ksmonkey123/moba3/docs/images/ref/left details.JPEG

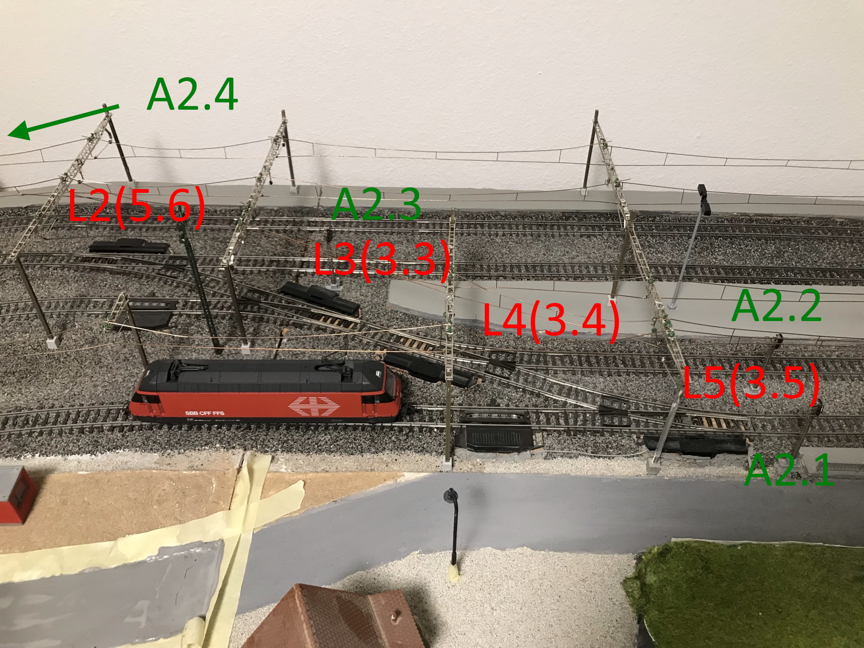
docs/images/ref/left details.JPEG
