ksmonkey123/moba3/docs/images/ref/left overview.JPEG

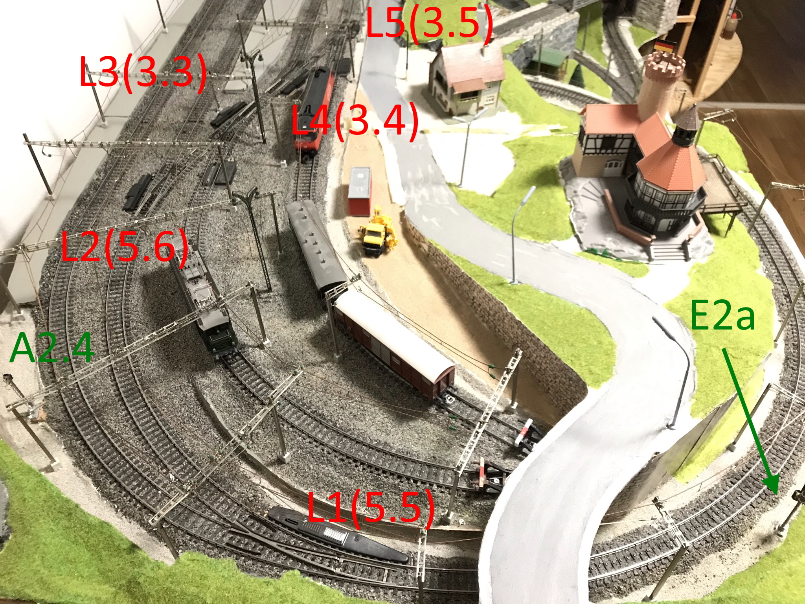
docs/images/ref/left overview.JPEG
