ksmonkey123/moba3/docs/images/ref/right front.JPEG

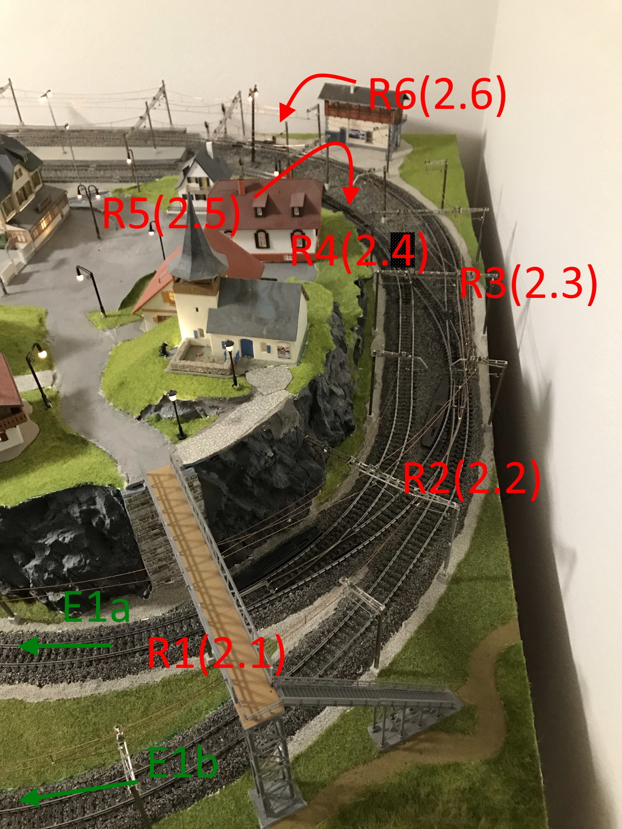
docs/images/ref/right front.JPEG
