ksmonkey123/moba3/docs/images/ref/right rear.JPEG

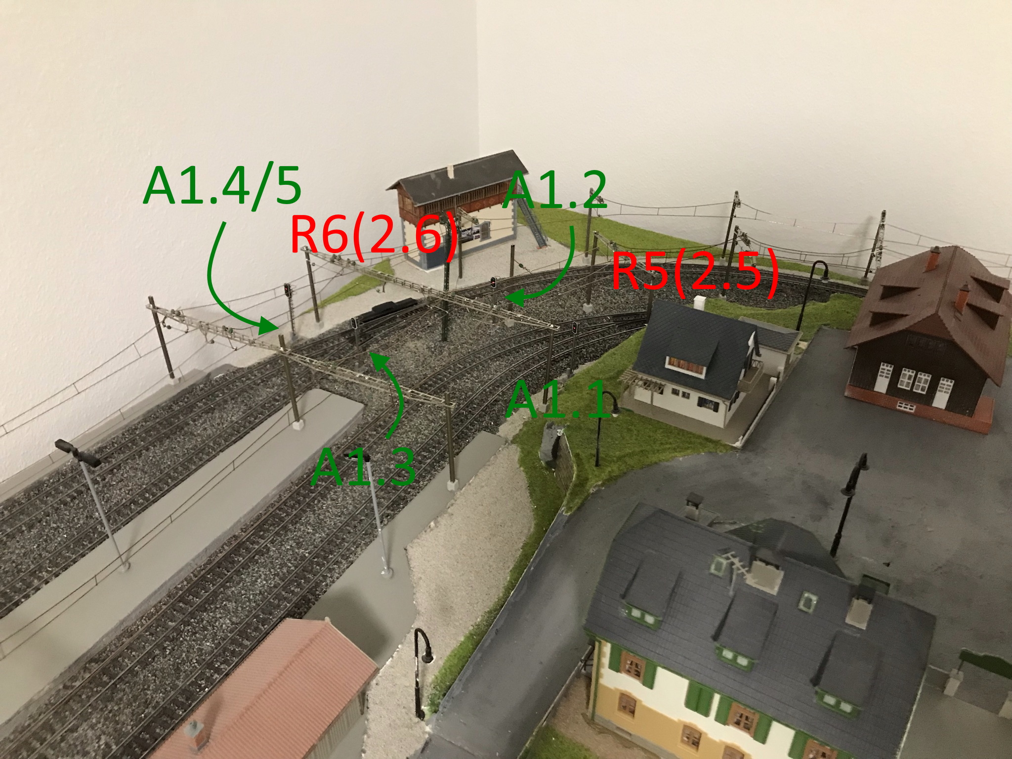
docs/images/ref/right rear.JPEG
