ksmonkey123/moba3/docs/images/ref/track top.JPEG

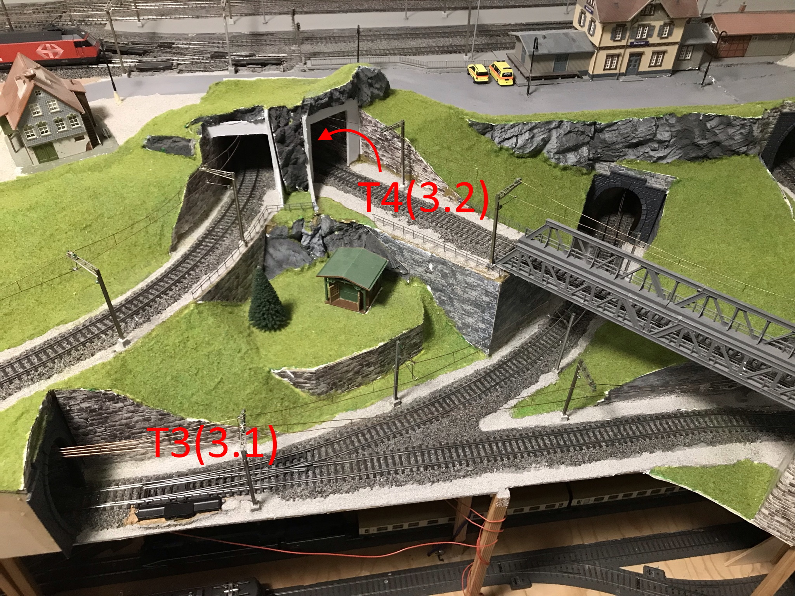
docs/images/ref/track top.JPEG
