ksmonkey123/moba3/docs/images/ref/yard 2.JPEG

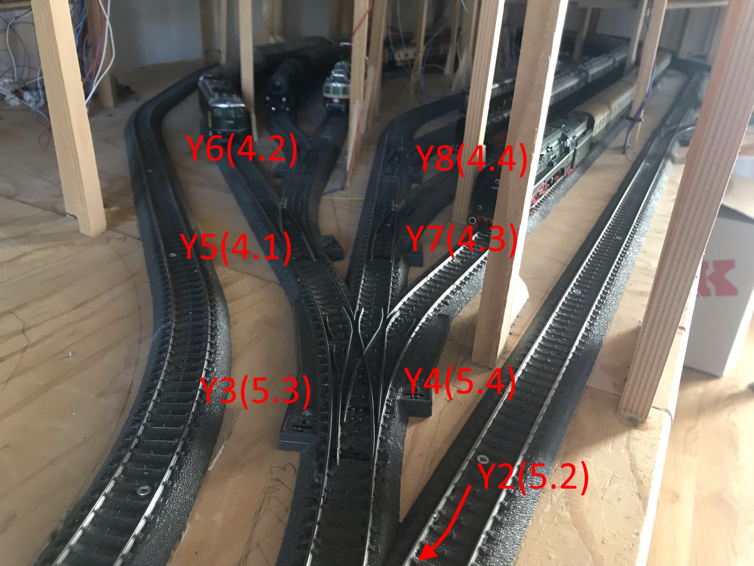
docs/images/ref/yard 2.JPEG
