ksmonkey123/moba3/docs/images/ref/yard 3.JPEG

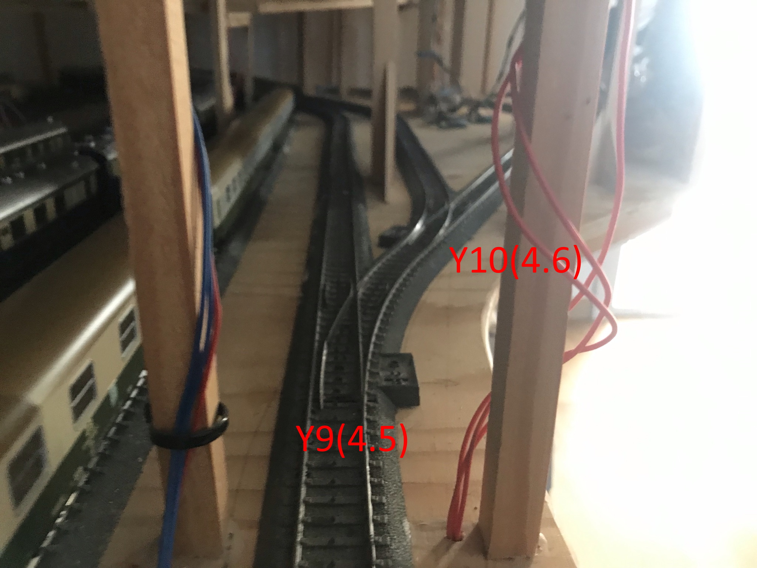
docs/images/ref/yard 3.JPEG
