ksmonkey123/moba3/docs/images/ref/yard entry.JPEG

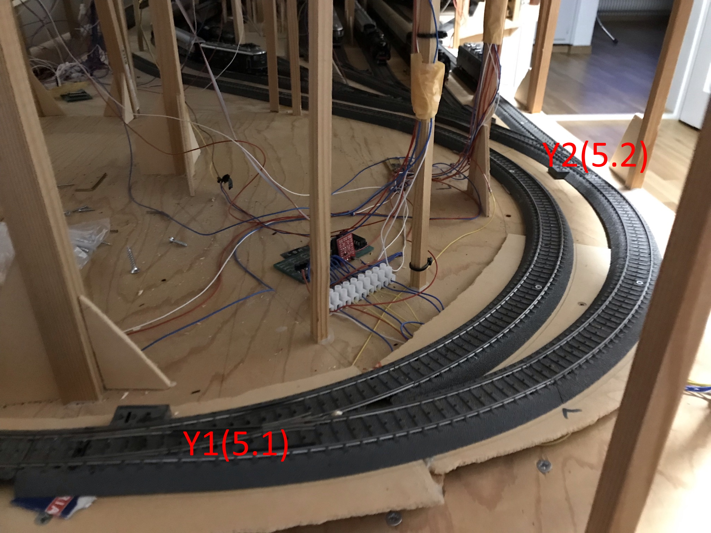
docs/images/ref/yard entry.JPEG
