ksmonkey123/moba3/pcbs/servo_driver/servo_driver.png

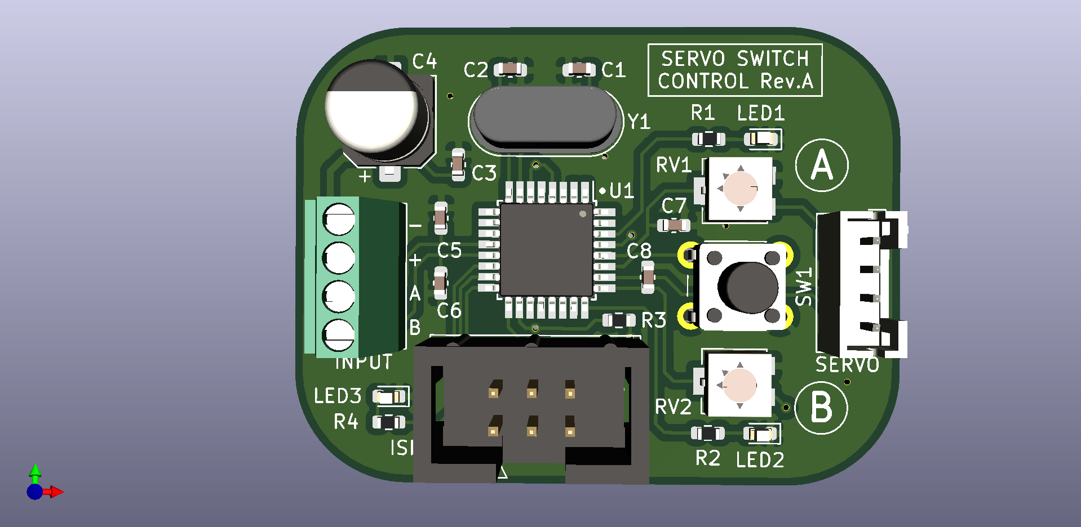
pcbs/servo_driver/servo_driver.png
