ksmonkey123/moba3/(threads)

Thread 2 (2021-09-07):

Staggered switch commands

ksmonkey123, 2021-09-07:
issuing all switch commands at once may overload power delivery.
stagger switch commands to reduce peak current.

Closed 2021-09-07.

Thread 4 (2021-09-07):

force re-driving of all switches when switch PSU is enabled

ksmonkey123, 2021-09-07:
the state of the switch PSU is monitored by the I/O board as a simple button.

When the switch PSU is enabled all switch commands should be retransmitted to force the switches into the correct states.
This retransmission should use the forced command structure introduced in #3

Retransmission should be staggered, cover all switches and should interrupt any other switch commands from being transmitted.

Closed 2021-09-07.

Thread 5 (2021-09-07):

continuous retransmission of commands

ksmonkey123, 2021-09-07:
Since commands are only transmitted once, a decoder may miss a command. this could be a critical failure, especially for switch decoders.

When no new commands are issued start retransmitting commands at a regular interval (e.g. once per second).
This allows controllers to re-receive commands that may have been missed.

As we expect high reliability of the transmissions, we do not need any staggering of commands here as this is simply a fail-safe mechanism.

This should be implemented for all command types:
- [x] Switches
- [x] Entry Signals
- [x] Exit Signals
- [x] Display Data
- [x] #10

Closed 2021-09-08.
