ksmonkey123/moba3/pcbs/controller_uno_shield/controller_uno_shield.kicad_pcb

## KiCad design pcbs/controller_uno_shield/controller_uno_shield.kicad_pcb (2022-11-25)

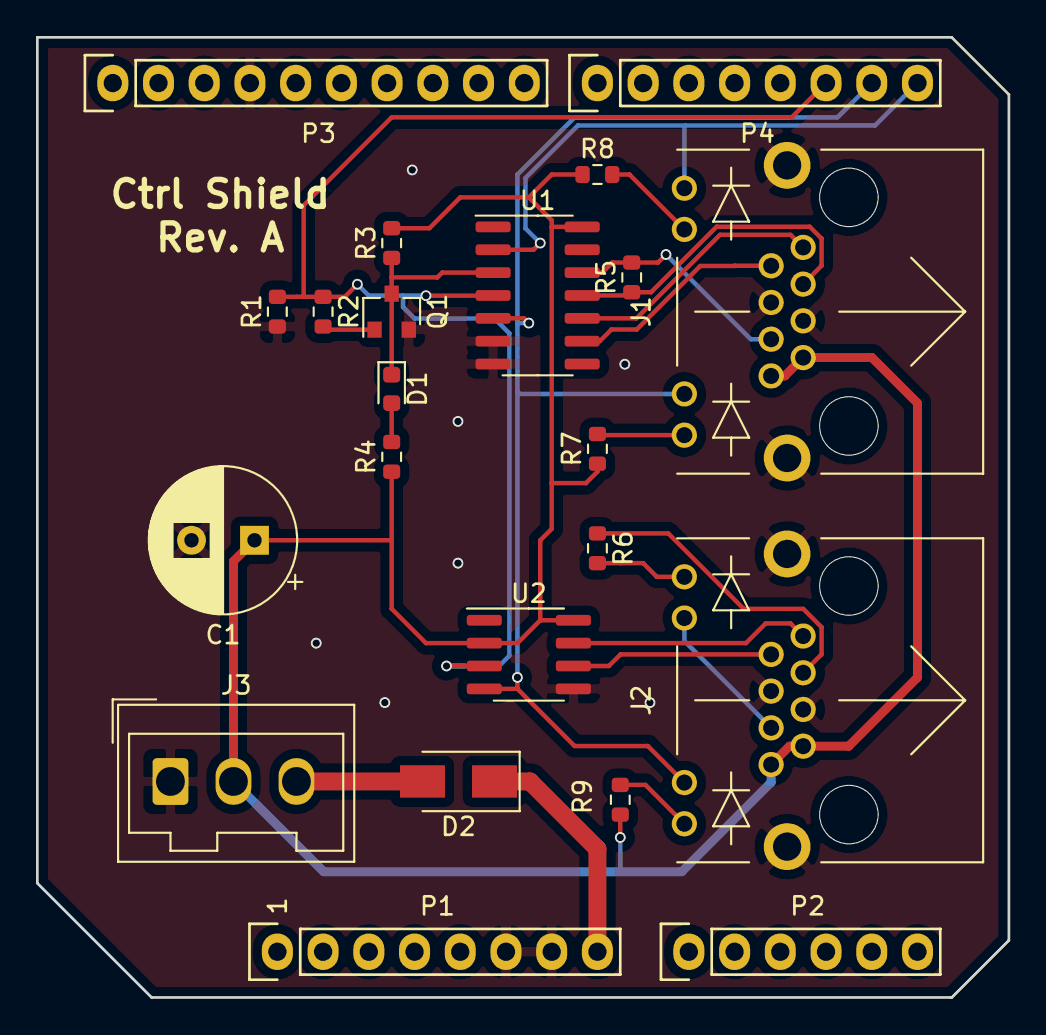
[picture p22: board controller_uno_shield.kicad_pcb from above]

Board: 2 copper layers, 54.0 x 53.3 mm, 22 parts (0 on the bottom side), 24 nets.

Parts:
C1: CP; CP_Radial_D8.0mm_P3.50mm
D1: LED; LED_0603_1608Metric
D2: D_Schottky; D_SMA
J1, J2: RJ45_LED_Shielded; RND_RJ45_LED
J3: Screw_Terminal_01x03; Wago_734-133_1x03_P3.50mm_Vertical
P1: Power; Socket_Strip_Arduino_1x08
P2: Analog; Socket_Strip_Arduino_1x06
P3: Digital; Socket_Strip_Arduino_1x10
P4: Digital; Socket_Strip_Arduino_1x08
Q1: 2N7002; SOT-23
R1, R2, R3, R4: 10k; R_0603_1608Metric
R5: 2k; R_0603_1608Metric
R6, R7, R8, R9: 1k; R_0603_1608Metric
U1: MAX489E; SOIC-14_3.9x8.7mm_P1.27mm
U2: MAX481E; SOIC-8_3.9x4.9mm_P1.27mm

Connections:
5V: C1.1, J1.7, J1.8, J2.7, J2.8, J3.2, R3.2, R4.1, R7.1, R8.1, R9.1, U1.14, U2.2, U2.8
/0(Rx): J1.9, P4.8, U1.2
/1(Tx): J1.11, J2.11, P4.7, U1.5, U2.4
/2: P4.6, R1.2, R2.1, U1.4, U2.3
/A4(SDA): P2.5, P3.2
/A5(SCL): P2.6, P3.1
/Vin: D2.1, P1.8
/networking/~rx_en: D1.1, Q1.3, R3.1, U1.3
GND: C1.2, J1.4, J1.5, J1.SH, J2.4, J2.5, J2.SH, J3.1, P1.6, P1.7, P3.4, Q1.2, R1.1, U1.6, U1.7, U2.5
unnamed: D1.2, R4.2
unnamed: D2.2, J3.3
unnamed: J1.1, U1.10
unnamed: J1.2, U1.9
unnamed: J1.3, R5.1, U1.11
unnamed: J1.6, R5.2, U1.12
unnamed: J1.10, R8.2
unnamed: J1.12, R7.2
unnamed: J2.1, U2.7
unnamed: J2.2, U2.6
unnamed: J2.3, R6.1
unnamed: J2.9, R6.2
unnamed: J2.6, J2.10
unnamed: J2.12, R9.2
unnamed: Q1.1, R2.2
