ksmonkey123/moba3/pcbs/servo_driver/servo_driver.kicad_pcb

## KiCad design pcbs/servo_driver/servo_driver.kicad_pcb (2021-12-11)

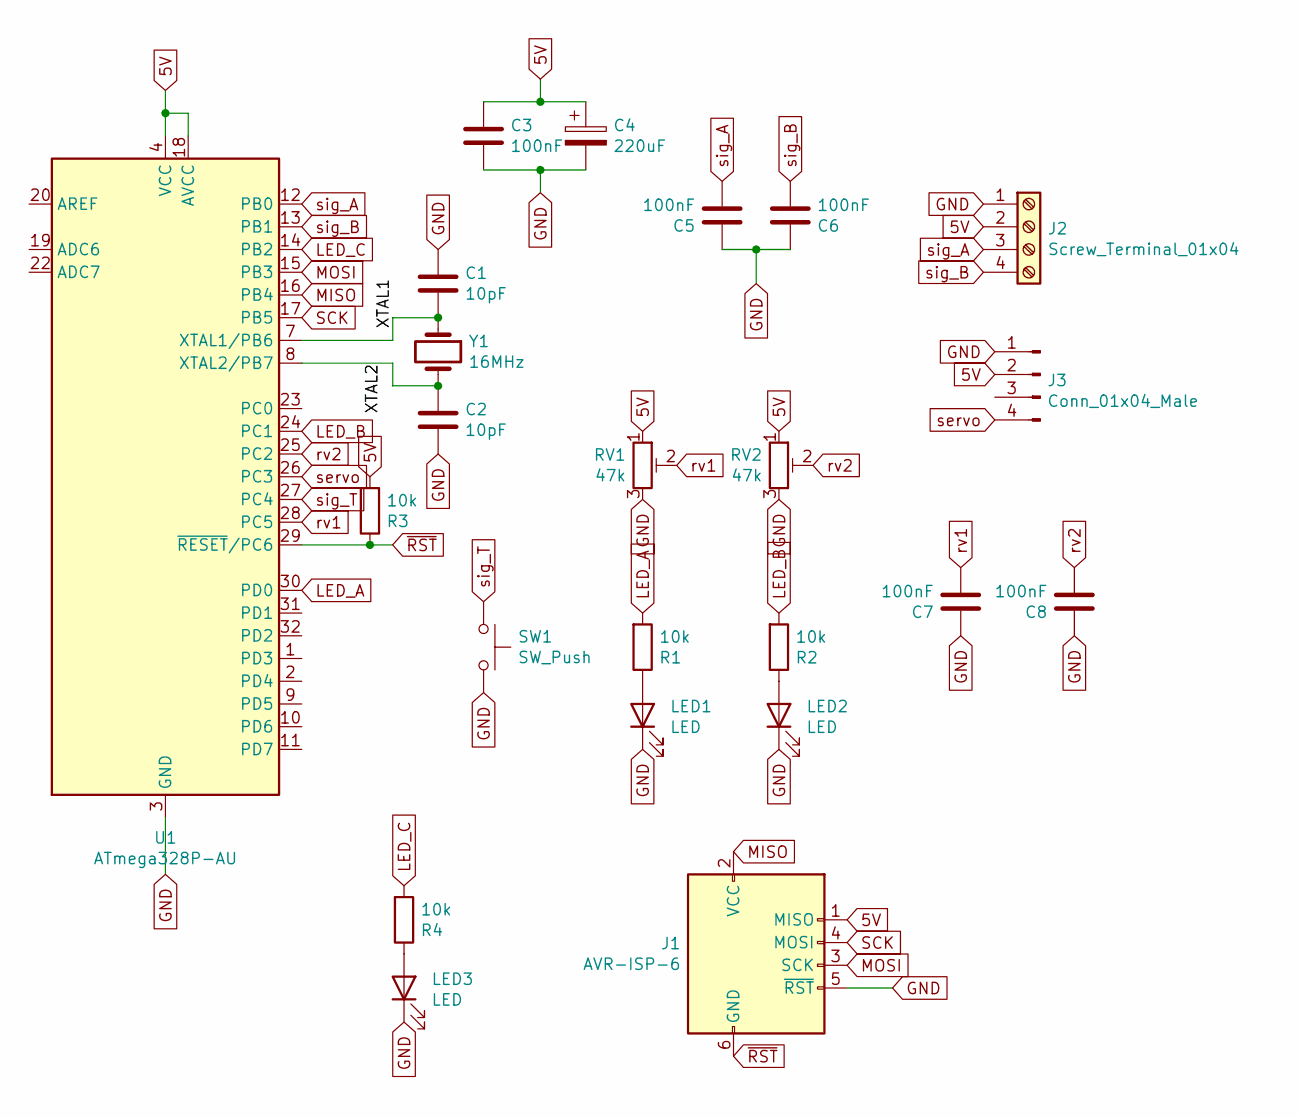
[picture p23: schematic servo_driver.sch, Moba3 - Decoder / Controller]

Parts:
C1, C2: 10pF; C_0603_1608Metric
C3, C5, C6, C7, C8: 100nF; C_0603_1608Metric
C4: 220uF; CP_Elec_6.3x7.7
J1: AVR-ISP-6; IDC-Header_2x03_P2.54mm_Vertical
J2: Screw_Terminal_01x04; TerminalBlock_Phoenix_MPT-0,5-4-2.54_1x04_P2.54mm_Horizontal
J3: Conn_01x04_Male; JST_PH_B4B-PH-K_1x04_P2.00mm_Vertical
LED1, LED2, LED3: LED; LED_0603_1608Metric
R1, R2, R3, R4: 10k; R_0603_1608Metric
RV1, RV2: 47k; Potentiometer_Bourns_3314J_Vertical
SW1: SW_Push; SW_PUSH_6mm_H7.3mm
U1: ATmega328P-AU; TQFP-32_7x7mm_P0.8mm
Y1: 16MHz; Crystal_HC49-4H_Vertical

Connections:
5V: C3.2, C4.1, J1.1 (MISO), J2.2, J3.2, R3.2, RV1.1, RV2.1, U1.4 (VCC), U1.6 (VCC), U1.18 (AVCC)
/XTAL1: C1.1, U1.7 (XTAL1/PB6), Y1.1
/XTAL2: C2.2, U1.8 (XTAL2/PB7), Y1.2
GND: C1.2, C2.1, C3.1, C4.2, C5.2, C6.2, C7.2, C8.2, J1.5 (~RST), J2.1, J3.1, LED1.1 (K), LED2.1 (K), LED3.1 (K), RV1.3, RV2.3, SW1.2, U1.3 (GND), U1.5 (GND), U1.21 (GND)
LED_A: R1.2, U1.30 (PD0)
LED_B: R2.2, U1.24 (PC1)
LED_C: R4.2, U1.14 (PB2)
MISO: J1.2 (VCC), U1.16 (PB4)
MOSI: J1.3 (SCK), U1.15 (PB3)
unnamed: LED1.2 (A), R1.1
unnamed: LED2.2 (A), R2.1
unnamed: LED3.2 (A), R4.1
SCK: J1.4 (MOSI), U1.17 (PB5)
rv1: C7.1, RV1.2, U1.28 (PC5)
rv2: C8.1, RV2.2, U1.25 (PC2)
servo: J3.4, U1.26 (PC3)
sig_A: C5.1, J2.3, U1.12 (PB0)
sig_B: C6.1, J2.4, U1.13 (PB1)
sig_T: SW1.1, U1.27 (PC4)
~RST: J1.6 (GND), R3.1, U1.29 (~RESET~/PC6)

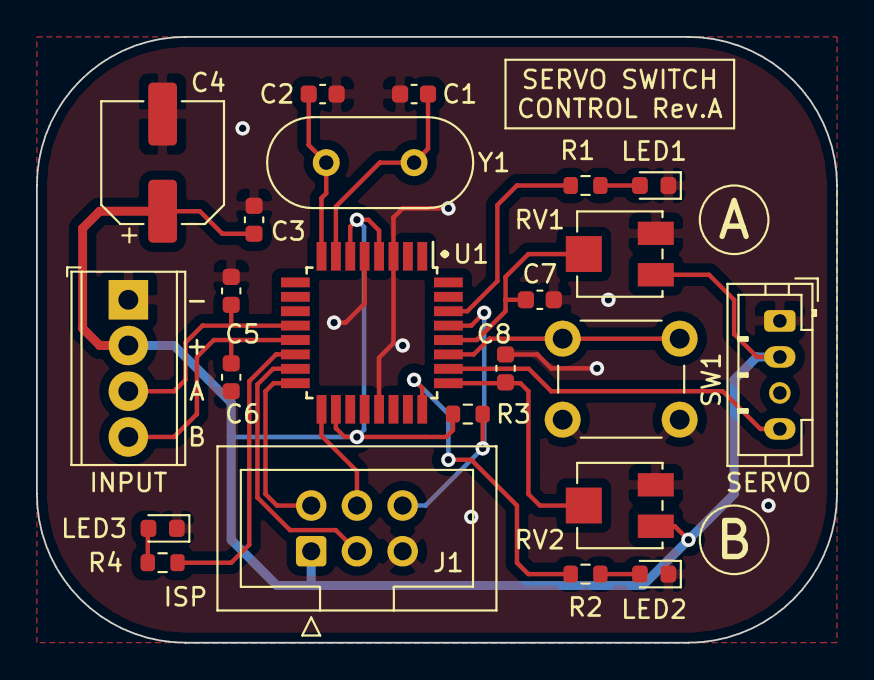
[picture p24: board servo_driver.kicad_pcb from above]

Board: 2 copper layers, 44.4 x 33.7 mm, 23 parts (0 on the bottom side), 20 nets.
