ksmonkey123/moba3/pcbs/programming_shield/shield/shield.kicad_pcb

## KiCad design pcbs/programming_shield/shield/shield.kicad_pcb (2021-07-13)

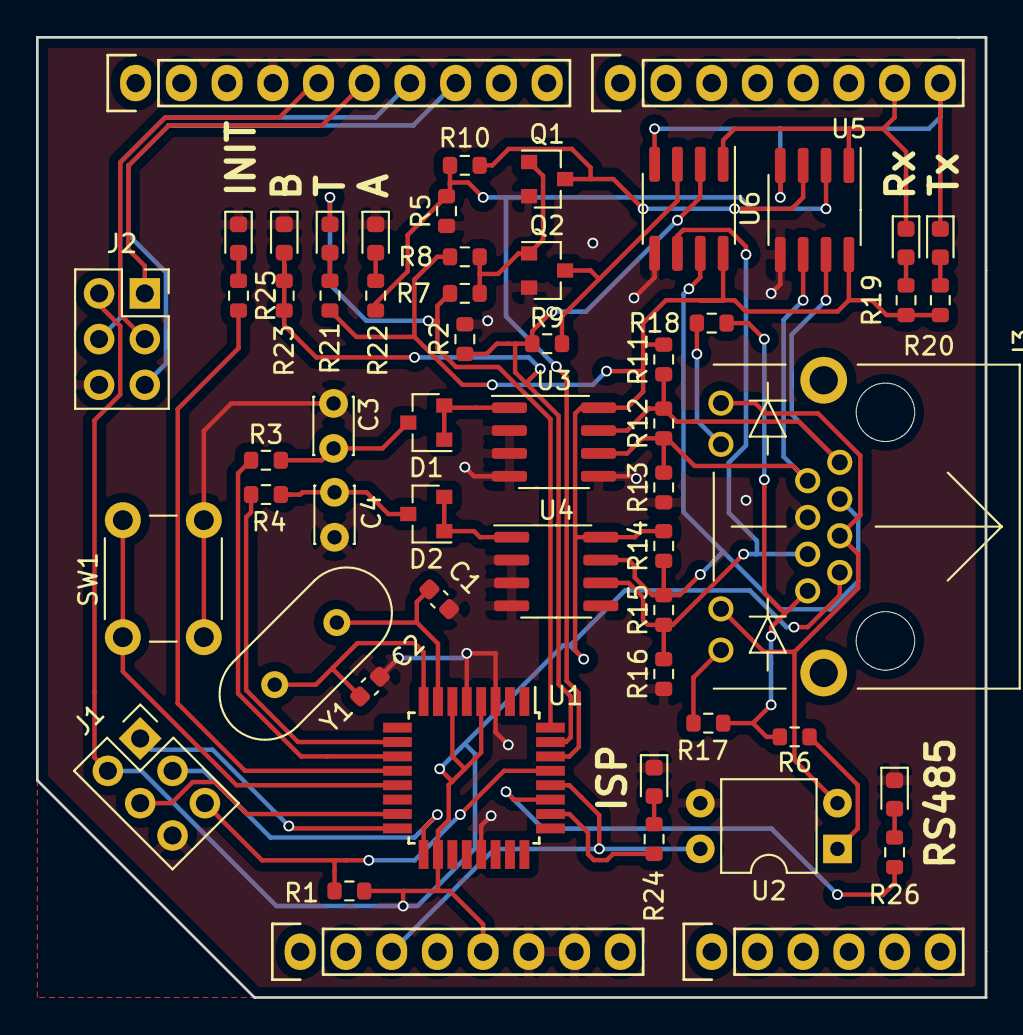
[picture p25: board shield.kicad_pcb from above]

Board: 2 copper layers, 52.7 x 53.3 mm, 57 parts (0 on the bottom side), 48 nets.

Parts:
C1, C2: 10pF; C_0603_1608Metric
C3, C4: 100nF; C_Disc_D3.0mm_W2.0mm_P2.50mm
D1, D2: BAT54CW; SOT-23
D3, D4, D5, D6, D7, D8, D9, D10: LED; LED_0603_1608Metric
J1, J2: AVR-ISP-6; PinSocket_2x03_P2.54mm_Vertical
J3: RJ45_LED; RND_RJ45_LED
P1: Power; Socket_Strip_Arduino_1x08
P2: Analog; Socket_Strip_Arduino_1x06
P3: Digital; Socket_Strip_Arduino_1x10
P4: Digital; Socket_Strip_Arduino_1x08
Q1, Q2: 2N7002; SOT-23
R1, R2, R5, R7, R8, R9, R10, R12, R15: 10k; R_0603_1608Metric
R3, R4, R6, R11, R13, R14, R16: 1k; R_0603_1608Metric
R17, R18, R19, R20, R21, R22, R23, R24, R25, R26: R; R_0603_1608Metric
SW1: SW_Push; SW_PUSH_6mm
U1: ATmega328P-AU; TQFP-32_7x7mm_P0.8mm
U2: EL817; DIP-4_W7.62mm
U3, U4, U5, U6: ST485EBDR; SOIC-8_3.9x4.9mm_P1.27mm
Y1: 16MHz; Crystal_HC49-4H_Vertical

Connections:
+5V: J1.2, J2.2, J3.7, P1.5, R1.2, R8.1, R11.2, R14.2, R19.2, R20.2, R21.2, U1.4, U1.6, U1.18, U3.8, U4.8, U5.8, U6.8
/0(Rx): D4.1, P4.8, U5.4, U6.4
/1(Tx): D3.1, P4.7, U5.1, U6.1
/10(**/SS): J2.5, P3.8
/11(**/MOSI): J2.4, P3.7
/12(MISO): J2.1, P3.6
/13(SCK): J2.3, P3.5
/CopMISO: J1.1, U1.16
/CopMOSI: J1.4, U1.15
/CopRST: J1.5, R1.1, U1.29
/CopSCK: J1.3, U1.17
/Reset: P1.3, U1.28, U2.4
/driveA: R5.2, R10.2, R22.2, U1.30, U5.2
/driveB: R2.1, R9.1, R23.2, U1.31, U6.2
/driveInhibit: D5.1, R7.1, U1.32
/sense+: J3.8, R6.2, R17.1, R18.1
/sense-: J3.5, J3.9, J3.11, U2.2
GND: C1.1, C2.2, C3.2, C4.2, D6.1, D7.1, D8.1, D9.1, D10.1, J1.6, J2.6, J3.4, P1.6, P1.7, P3.4, Q1.2, Q2.2, R2.2, R5.1, R13.1, R16.1, SW1.2, U1.3, U1.5, U1.21, U2.3, U3.2, U3.3, U3.4, U3.5, U4.2, U4.3, U4.4, U4.5, U5.5, U6.5
unnamed: C1.2, U1.7, Y1.1
unnamed: C2.1, U1.8, Y1.2
unnamed: C3.1, D1.3, R3.2
unnamed: C4.1, D2.3, R4.2
unnamed: D1.1, D1.2, U3.1
unnamed: D2.1, D2.2, U4.1
unnamed: D3.2, R19.1
unnamed: D4.2, R20.1
unnamed: D5.2, R21.1
unnamed: D6.2, R22.1
unnamed: D7.2, R23.1
unnamed: D8.2, R24.1
unnamed: D9.2, R25.1
unnamed: D10.2, R26.1
unnamed: J3.1, R11.1, R12.2, U3.7, U5.7
unnamed: J3.2, R12.1, R13.2, U3.6, U5.6
unnamed: J3.3, R14.1, R15.2, U4.7, U6.7
unnamed: J3.6, R15.1, R16.2, U4.6, U6.6
unnamed: J3.10, R18.2
unnamed: J3.12, R17.2
unnamed: Q1.1, Q2.1, R7.2, R8.2
unnamed: Q1.3, R10.1, U5.3
unnamed: Q2.3, R9.2, U6.3
unnamed: R3.1, U1.11
unnamed: R4.1, U1.10
unnamed: R6.1, U2.1
unnamed: R24.2, U1.26
unnamed: R25.2, U1.12
unnamed: R26.2, U1.27
unnamed: SW1.1, U1.13
