ksmonkey123/moba3/pcbs/interface/interface.kicad_pcb

## KiCad design pcbs/interface/interface.kicad_pcb (2021-07-13)

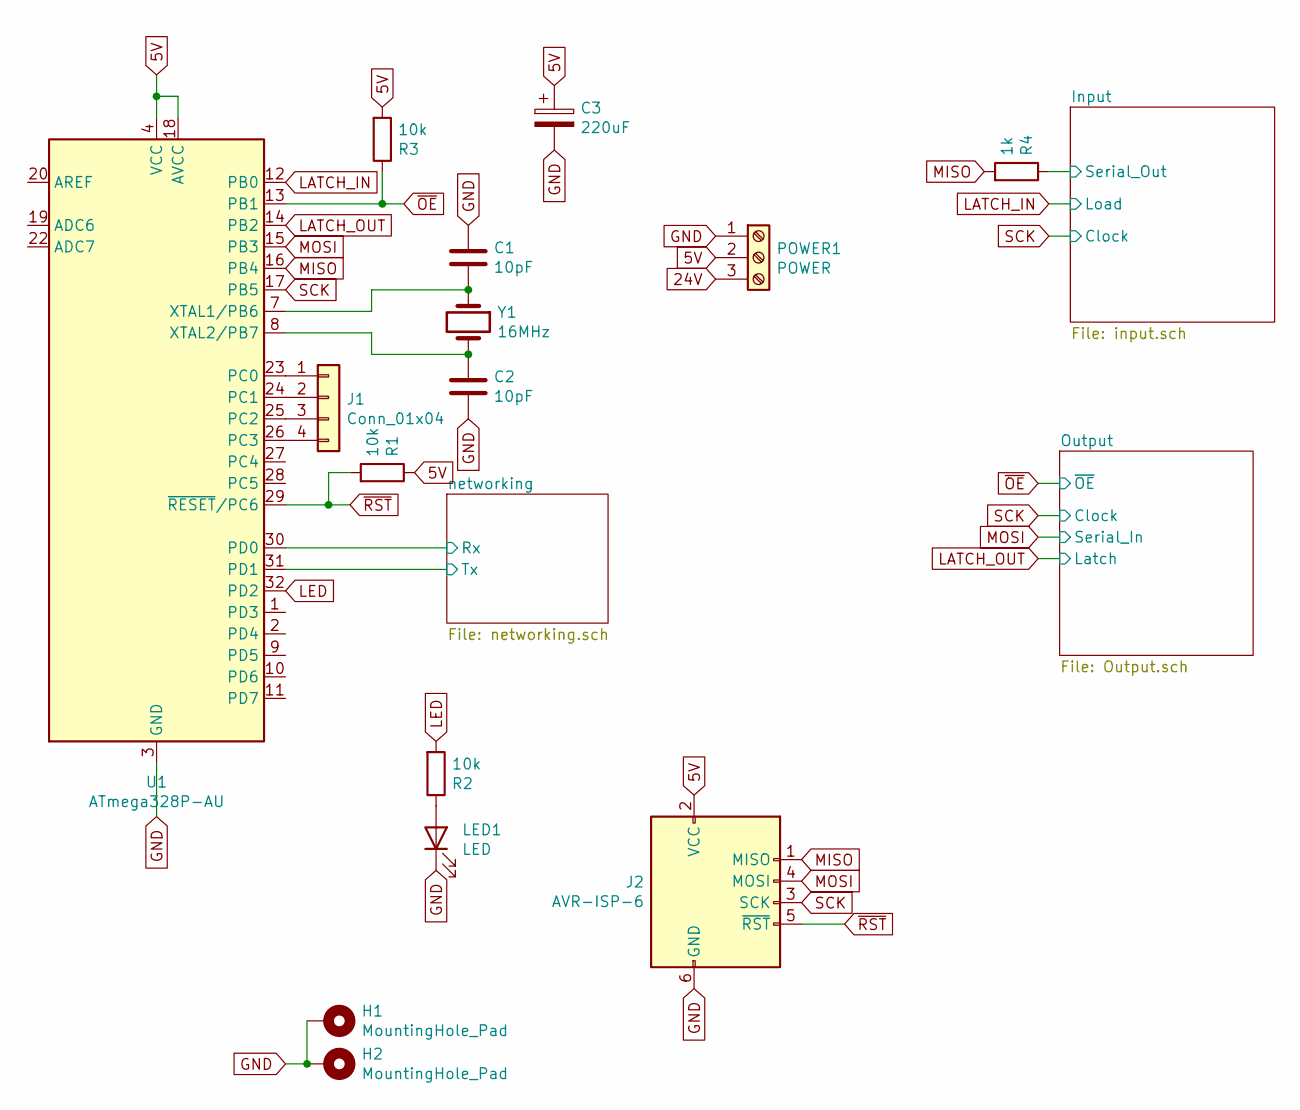
[picture p26: schematic interface.sch, Moba3 - Decoder / Controller]

Parts:
C1, C2: 10pF; C_0603_1608Metric
C3: 220uF; CP_Radial_D8.0mm_P3.50mm
H1, H2: MountingHole_Pad; MountingHole_3.5mm_Pad_Via
J1: Conn_01x04; PinHeader_1x04_P2.54mm_Vertical
J2: AVR-ISP-6; PinSocket_2x03_P2.54mm_Vertical
LED1: LED; LED_0603_1608Metric
POWER1: POWER; Wago_734-133_1x03_P3.50mm_Vertical
R1, R2, R3: 10k; R_0603_1608Metric
R4: 1k; R_0603_1608Metric
U1: ATmega328P-AU; TQFP-32_7x7mm_P0.8mm
Y1: 16MHz; Crystal_HC49-4H_Vertical

Connections:
5V: C3.1, J2.2 (VCC), POWER1.2, R1.1, R3.2, U1.4 (VCC), U1.6 (VCC), U1.18 (AVCC); also elsewhere on the board
/Input/Serial_Out: R4.1; also elsewhere on the board
/networking/Rx: U1.30 (PD0); also elsewhere on the board
/networking/Tx: U1.31 (PD1); also elsewhere on the board
GND: C1.2, C2.1, C3.2, H1.1, H2.1, J2.6 (GND), LED1.1 (K), POWER1.1, U1.3 (GND), U1.5 (GND), U1.21 (GND); also elsewhere on the board
LATCH_IN: U1.12 (PB0); also elsewhere on the board
LATCH_OUT: U1.14 (PB2); also elsewhere on the board
LED: R2.2, U1.32 (PD2)
MISO: J2.1 (MISO), R4.2, U1.16 (PB4)
MOSI: J2.4 (MOSI), U1.15 (PB3); also elsewhere on the board
unnamed: C1.1, U1.7 (XTAL1/PB6), Y1.1
unnamed: C2.2, U1.8 (XTAL2/PB7), Y1.2
unnamed: J1.1, U1.23 (PC0)
unnamed: J1.2, U1.24 (PC1)
unnamed: J1.3, U1.25 (PC2)
unnamed: J1.4, U1.26 (PC3)
unnamed: LED1.2 (A), R2.1
SCK: J2.3 (SCK), U1.17 (PB5); also elsewhere on the board
~OE: R3.1, U1.13 (PB1); also elsewhere on the board
~RST: J2.5 (~RST), R1.2, U1.29 (~RESET~/PC6)

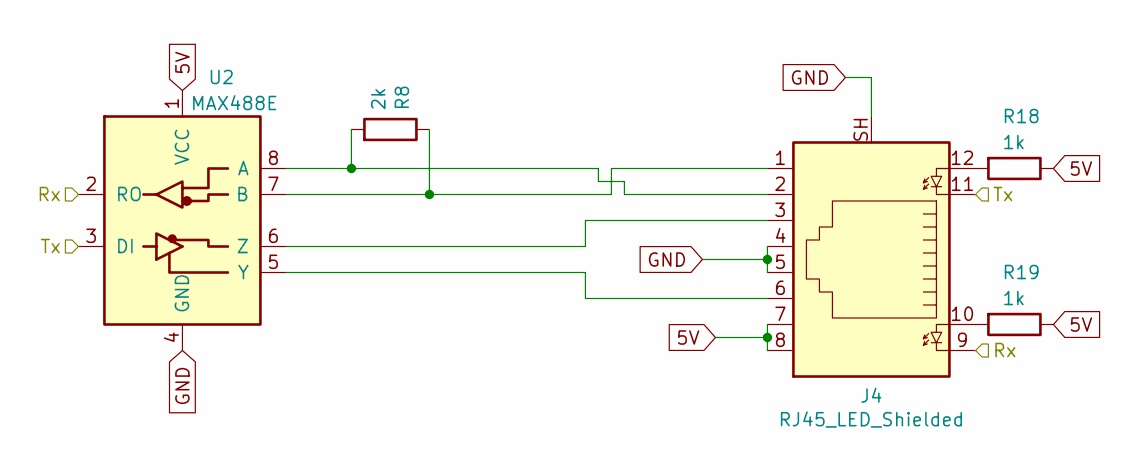
[picture p27: schematic networking.sch, Moba3 - Decoder / Controller]

Parts:
J4: RJ45_LED_Shielded; RND_RJ45_LED
R8: 2k; R_0603_1608Metric
R18, R19: 1k; R_0603_1608Metric
U2: MAX488E; SOIC-8_3.9x4.9mm_P1.27mm

Connections:
5V: J4.7, J4.8, R18.1, R19.1, U2.1 (VCC); also elsewhere on the board
/networking/Rx: J4.9, U2.2 (RO); also elsewhere on the board
/networking/Tx: J4.11, U2.3 (DI); also elsewhere on the board
GND: J4.4, J4.5, J4.SH, U2.4 (GND); also elsewhere on the board
unnamed: J4.1, R8.1, U2.7 (B)
unnamed: J4.2, R8.2, U2.8 (A)
unnamed: J4.3, U2.6 (Z)
unnamed: J4.6, U2.5 (Y)
unnamed: J4.10, R19.2
unnamed: J4.12, R18.2

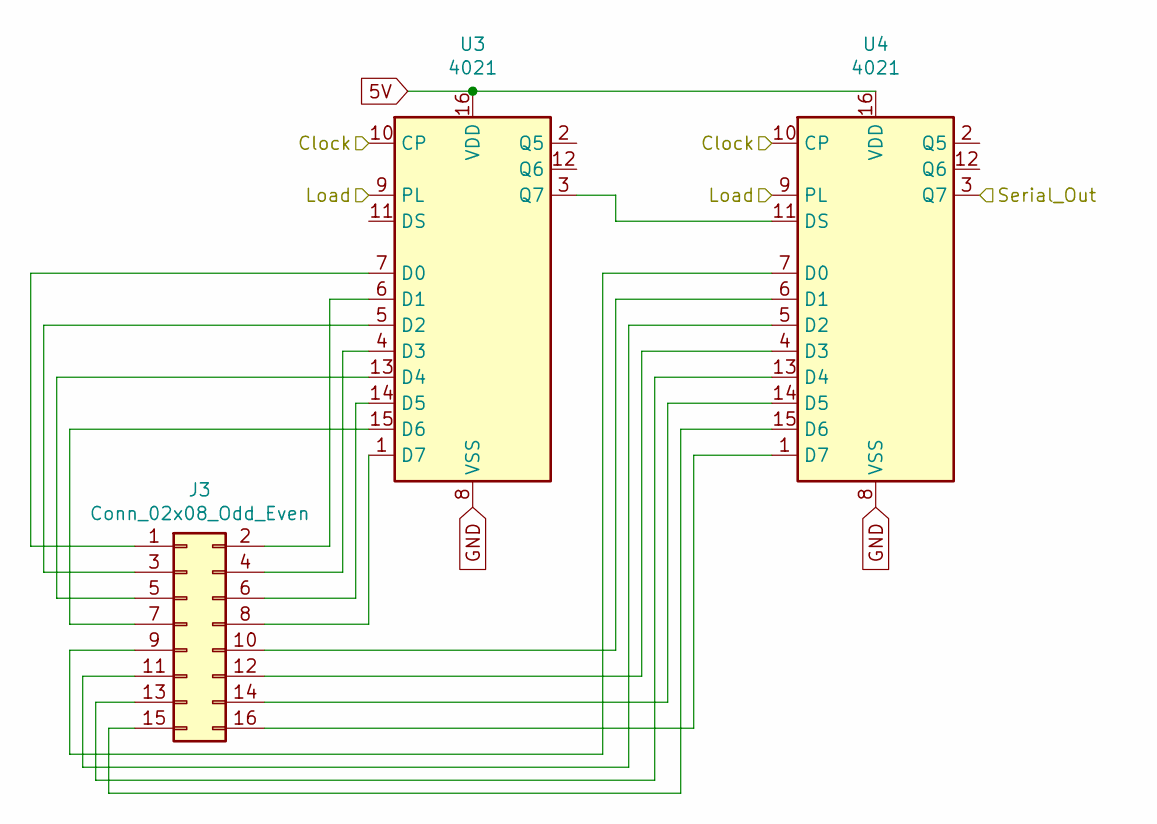
[picture p28: schematic input.sch]

Parts:
J3: Conn_02x08_Odd_Even; PinHeader_2x08_P2.54mm_Vertical
U3, U4: 4021; SOIC-16_3.9x9.9mm_P1.27mm

Connections:
5V: U3.16 (VDD), U4.16 (VDD); also elsewhere on the board
/Input/Serial_Out: U4.3 (Q7); also elsewhere on the board
GND: U3.8 (VSS), U4.8 (VSS); also elsewhere on the board
LATCH_IN: U3.9 (PL), U4.9 (PL); also elsewhere on the board
unnamed: J3.1, U3.7 (D0)
unnamed: J3.2, U3.6 (D1)
unnamed: J3.3, U3.5 (D2)
unnamed: J3.4, U3.4 (D3)
unnamed: J3.5, U3.13 (D4)
unnamed: J3.6, U3.14 (D5)
unnamed: J3.7, U3.15 (D6)
unnamed: J3.8, U3.1 (D7)
unnamed: J3.9, U4.7 (D0)
unnamed: J3.10, U4.6 (D1)
unnamed: J3.11, U4.5 (D2)
unnamed: J3.12, U4.4 (D3)
unnamed: J3.13, U4.13 (D4)
unnamed: J3.14, U4.14 (D5)
unnamed: J3.15, U4.15 (D6)
unnamed: J3.16, U4.1 (D7)
unnamed: U3.3 (Q7), U4.11 (DS)
SCK: U3.10 (CP), U4.10 (CP); also elsewhere on the board

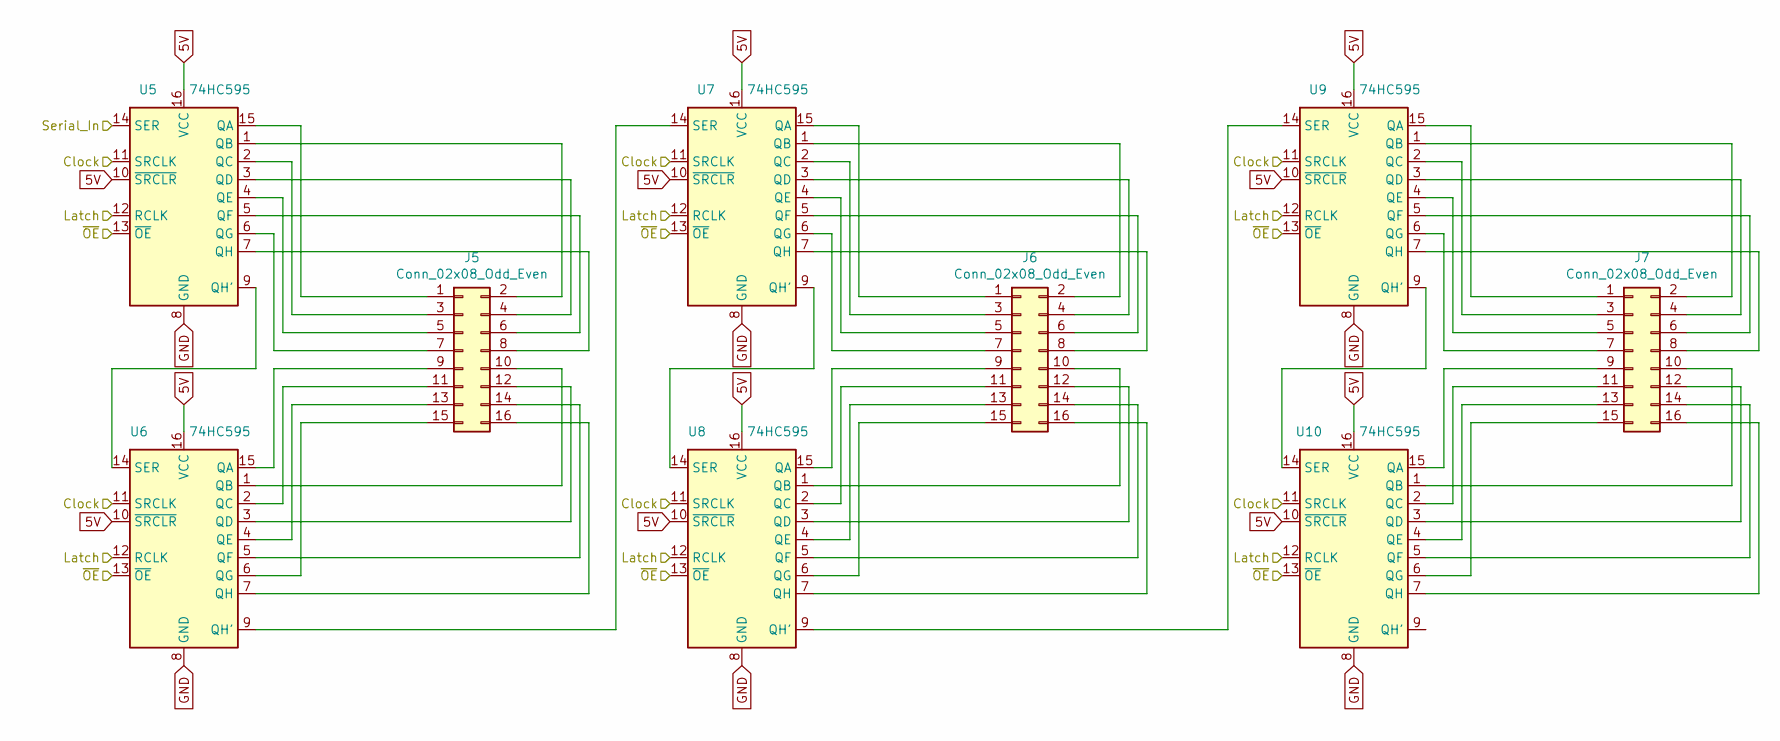
[picture p29: schematic Output.sch]

Parts:
J5, J6, J7: Conn_02x08_Odd_Even; PinHeader_2x08_P2.54mm_Vertical
U5, U6, U7, U8, U9, U10: 74HC595; SOIC-16_3.9x9.9mm_P1.27mm

Connections:
5V: U5.10 (~SRCLR), U5.16 (VCC), U6.10 (~SRCLR), U6.16 (VCC), U7.10 (~SRCLR), U7.16 (VCC), U8.10 (~SRCLR), U8.16 (VCC), U9.10 (~SRCLR), U9.16 (VCC), U10.10 (~SRCLR), U10.16 (VCC); also elsewhere on the board
GND: U5.8 (GND), U6.8 (GND), U7.8 (GND), U8.8 (GND), U9.8 (GND), U10.8 (GND); also elsewhere on the board
LATCH_OUT: U5.12 (RCLK), U6.12 (RCLK), U7.12 (RCLK), U8.12 (RCLK), U9.12 (RCLK), U10.12 (RCLK); also elsewhere on the board
MOSI: U5.14 (SER); also elsewhere on the board
unnamed: J5.1, U5.15 (QA)
unnamed: J5.2, U5.1 (QB)
unnamed: J5.3, U5.2 (QC)
unnamed: J5.4, U5.3 (QD)
unnamed: J5.5, U5.4 (QE)
unnamed: J5.6, U5.5 (QF)
unnamed: J5.7, U5.6 (QG)
unnamed: J5.8, U5.7 (QH)
unnamed: J5.9, U6.15 (QA)
unnamed: J5.10, U6.1 (QB)
unnamed: J5.11, U6.2 (QC)
unnamed: J5.12, U6.3 (QD)
unnamed: J5.13, U6.4 (QE)
unnamed: J5.14, U6.5 (QF)
unnamed: J5.15, U6.6 (QG)
unnamed: J5.16, U6.7 (QH)
unnamed: J6.1, U7.15 (QA)
unnamed: J6.2, U7.1 (QB)
unnamed: J6.3, U7.2 (QC)
unnamed: J6.4, U7.3 (QD)
unnamed: J6.5, U7.4 (QE)
unnamed: J6.6, U7.5 (QF)
unnamed: J6.7, U7.6 (QG)
unnamed: J6.8, U7.7 (QH)
unnamed: J6.9, U8.15 (QA)
unnamed: J6.10, U8.1 (QB)
unnamed: J6.11, U8.2 (QC)
unnamed: J6.12, U8.3 (QD)
unnamed: J6.13, U8.4 (QE)
unnamed: J6.14, U8.5 (QF)
unnamed: J6.15, U8.6 (QG)
unnamed: J6.16, U8.7 (QH)
unnamed: J7.1, U9.15 (QA)
unnamed: J7.2, U9.1 (QB)
unnamed: J7.3, U9.2 (QC)
unnamed: J7.4, U9.3 (QD)
unnamed: J7.5, U9.4 (QE)
unnamed: J7.6, U9.5 (QF)
unnamed: J7.7, U9.6 (QG)
unnamed: J7.8, U9.7 (QH)
unnamed: J7.9, U10.15 (QA)
unnamed: J7.10, U10.1 (QB)
unnamed: J7.11, U10.2 (QC)
unnamed: J7.12, U10.3 (QD)
unnamed: J7.13, U10.4 (QE)
unnamed: J7.14, U10.5 (QF)
unnamed: J7.15, U10.6 (QG)
unnamed: J7.16, U10.7 (QH)
unnamed: U5.9 (QH'), U6.14 (SER)
unnamed: U6.9 (QH'), U7.14 (SER)
unnamed: U7.9 (QH'), U8.14 (SER)
unnamed: U8.9 (QH'), U9.14 (SER)
unnamed: U9.9 (QH'), U10.14 (SER)
SCK: U5.11 (SRCLK), U6.11 (SRCLK), U7.11 (SRCLK), U8.11 (SRCLK), U9.11 (SRCLK), U10.11 (SRCLK); also elsewhere on the board
~OE: U5.13 (~OE), U6.13 (~OE), U7.13 (~OE), U8.13 (~OE), U9.13 (~OE), U10.13 (~OE); also elsewhere on the board

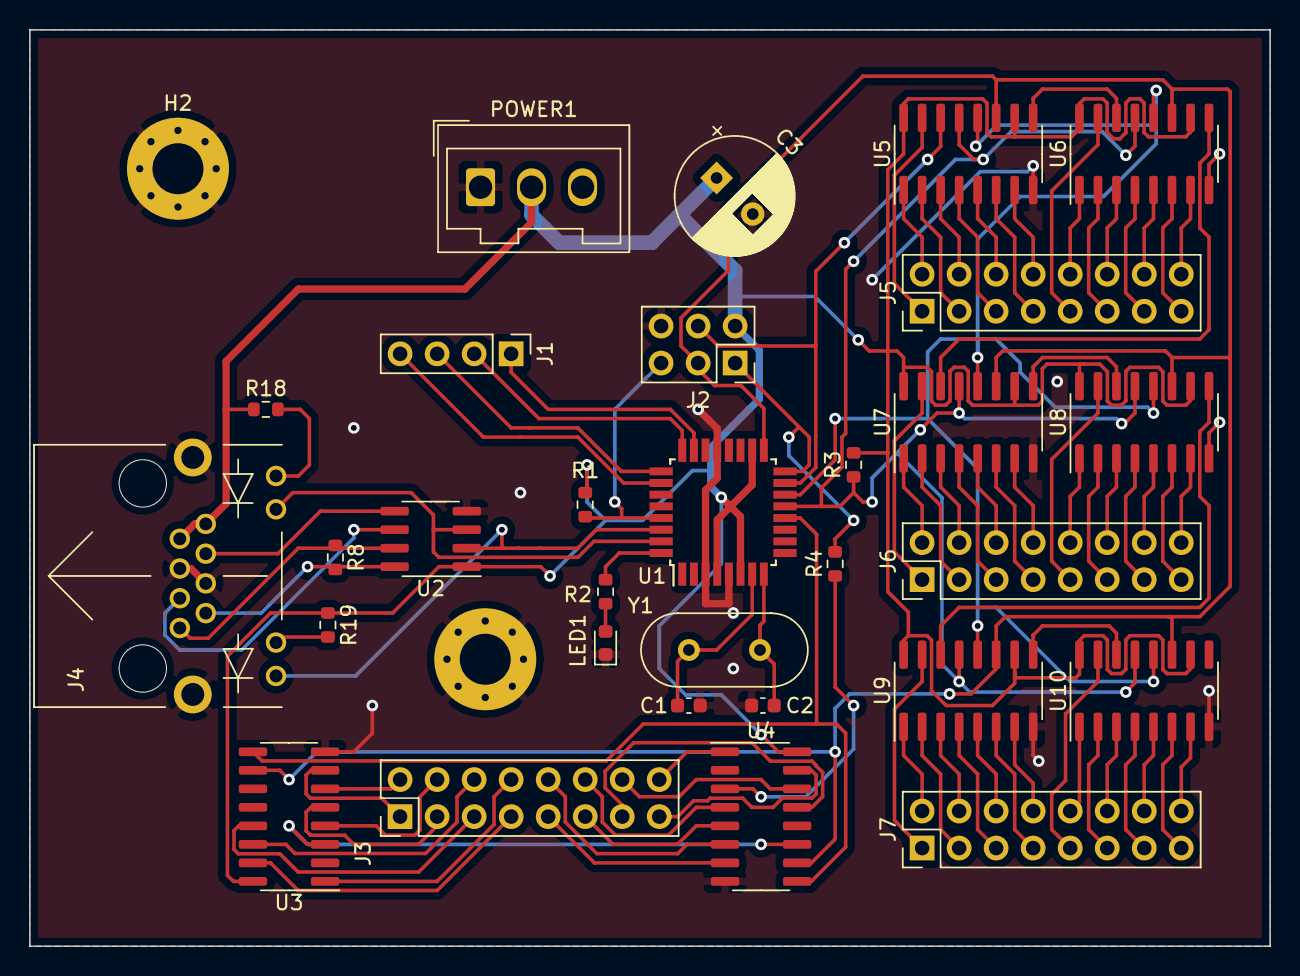
[picture p30: board interface.kicad_pcb from above]

Board: 2 copper layers, 85.1 x 62.9 mm, 32 parts (0 on the bottom side), 96 nets.
