ksmonkey123/moba3/pcbs/switch_decoder/decoder.kicad_pcb

## KiCad design pcbs/switch_decoder/decoder.kicad_pcb (2021-07-13)

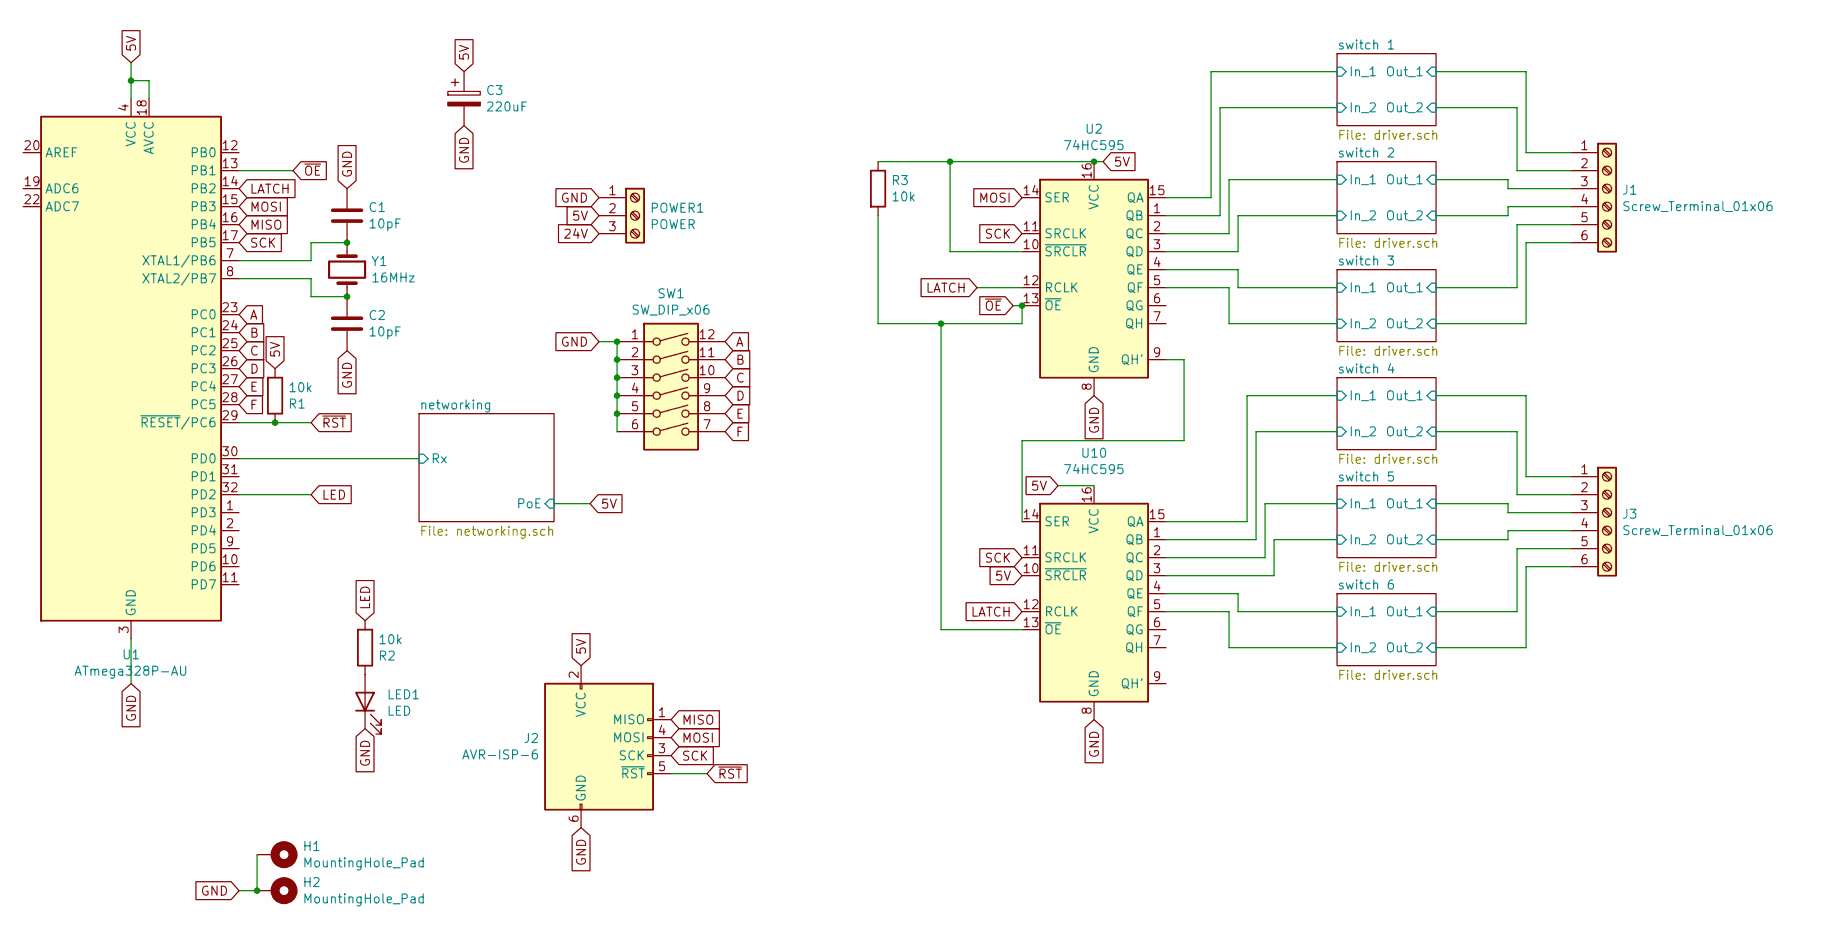
[picture p31: schematic decoder.sch, Moba3 - Decoder / Controller]

Parts:
C1, C2: 10pF; C_0603_1608Metric
C3: 220uF; CP_Radial_D8.0mm_P3.50mm
H1, H2: MountingHole_Pad; MountingHole_3.5mm_Pad_Via
J1, J3: Screw_Terminal_01x06; Wago_734-136_1x06_P3.50mm_Vertical
J2: AVR-ISP-6; PinSocket_2x03_P2.54mm_Vertical
LED1: LED; LED_0603_1608Metric
POWER1: POWER; Wago_734-133_1x03_P3.50mm_Vertical
R1, R2, R3: 10k; R_0603_1608Metric
SW1: SW_DIP_x06; SW_DIP_SPSTx06_Slide_KingTek_DSHP06TJ_W5.25mm_P1.27mm_JPin
U1: ATmega328P-AU; TQFP-32_7x7mm_P0.8mm
U2, U10: 74HC595; SOIC-16_3.9x9.9mm_P1.27mm
Y1: 16MHz; Crystal_HC49-4H_Vertical

Connections:
5V: C3.1, J2.2 (VCC), POWER1.2, R1.2, R3.1, U1.4 (VCC), U1.6 (VCC), U1.18 (AVCC), U2.10 (~SRCLR), U2.16 (VCC), U10.10 (~SRCLR), U10.16 (VCC); also elsewhere on the board
24V: POWER1.3; also elsewhere on the board
/networking/Rx: U1.30 (PD0); also elsewhere on the board
/switch 1/Out_1: J1.1; also elsewhere on the board
/switch 1/Out_2: J1.2; also elsewhere on the board
/switch 2/In_1: U2.2 (QC); also elsewhere on the board
/switch 2/Out_1: J1.3; also elsewhere on the board
/switch 2/Out_2: J1.4; also elsewhere on the board
/switch 3/In_1: U2.4 (QE); also elsewhere on the board
/switch 3/In_2: U2.5 (QF); also elsewhere on the board
/switch 3/Out_1: J1.5; also elsewhere on the board
/switch 3/Out_2: J1.6; also elsewhere on the board
/switch 4/In_1: U10.15 (QA); also elsewhere on the board
/switch 4/Out_1: J3.1; also elsewhere on the board
/switch 4/Out_2: J3.2; also elsewhere on the board
/switch 5/In_1: U10.2 (QC); also elsewhere on the board
/switch 5/In_2: U10.3 (QD); also elsewhere on the board
/switch 5/Out_1: J3.3; also elsewhere on the board
/switch 5/Out_2: J3.4; also elsewhere on the board
/switch 6/In_1: U10.4 (QE); also elsewhere on the board
/switch 6/In_2: U10.5 (QF); also elsewhere on the board
/switch 6/Out_1: J3.5; also elsewhere on the board
/switch 6/Out_2: J3.6; also elsewhere on the board
A: SW1.12, U1.23 (PC0)
B: SW1.11, U1.24 (PC1)
C: SW1.10, U1.25 (PC2)
D: SW1.9, U1.26 (PC3)
E: SW1.8, U1.27 (PC4)
F: SW1.7, U1.28 (PC5)
GND: C1.2, C2.1, C3.2, H1.1, H2.1, J2.6 (GND), LED1.1 (K), POWER1.1, SW1.1, SW1.2, SW1.3, SW1.4, SW1.5, SW1.6, U1.3 (GND), U1.5 (GND), U1.21 (GND), U2.8 (GND), U10.8 (GND); also elsewhere on the board
LATCH: U1.14 (PB2), U2.12 (RCLK), U10.12 (RCLK)
LED: R2.2, U1.32 (PD2)
MISO: J2.1 (MISO), U1.16 (PB4)
MOSI: J2.4 (MOSI), U1.15 (PB3), U2.14 (SER)
unnamed: C1.1, U1.7 (XTAL1/PB6), Y1.1
unnamed: C2.2, U1.8 (XTAL2/PB7), Y1.2
unnamed: LED1.2 (A), R2.1
unnamed: U2.9 (QH'), U10.14 (SER)
SCK: J2.3 (SCK), U1.17 (PB5), U2.11 (SRCLK), U10.11 (SRCLK)
~OE: R3.2, U1.13 (PB1), U2.13 (~OE), U10.13 (~OE)
~RST: J2.5 (~RST), R1.1, U1.29 (~RESET~/PC6)

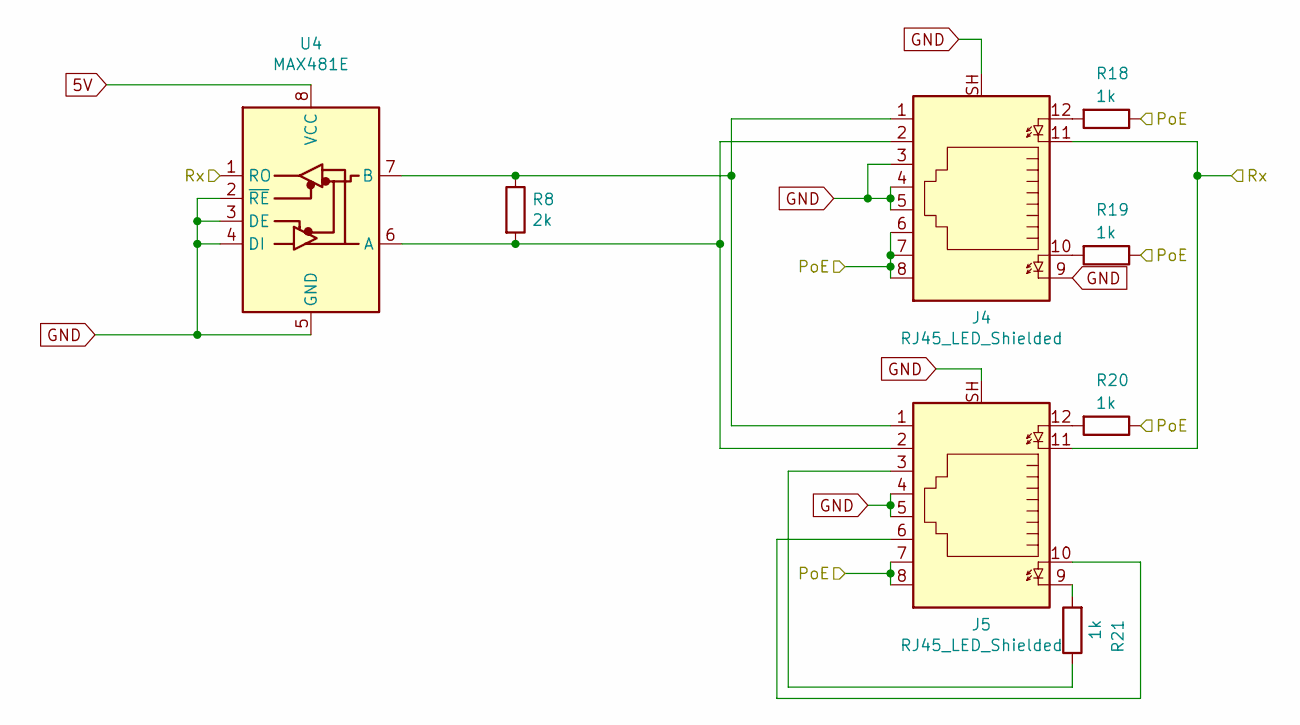
[picture p32: schematic networking.sch, Moba3 - Decoder / Controller]

Parts:
J4, J5: RJ45_LED_Shielded; RND_RJ45_LED
R8: 2k; R_0603_1608Metric
R18, R19, R20, R21: 1k; R_0603_1608Metric
U4: MAX481E; SOIC-8_3.9x4.9mm_P1.27mm

Connections:
5V: J4.6, J4.7, J4.8, J5.7, J5.8, R18.1, R19.1, R20.1, U4.8 (VCC); also elsewhere on the board
/networking/Rx: J4.11, J5.11, U4.1 (RO); also elsewhere on the board
GND: J4.3, J4.4, J4.5, J4.9, J4.SH, J5.4, J5.5, J5.SH, U4.2 (~RE), U4.3 (DE), U4.4 (DI), U4.5 (GND); also elsewhere on the board
unnamed: J4.1, J5.1, R8.1, U4.7 (B)
unnamed: J4.2, J5.2, R8.2, U4.6 (A)
unnamed: J4.10, R19.2
unnamed: J4.12, R18.2
unnamed: J5.3, R21.1
unnamed: J5.9, R21.2
unnamed: J5.6, J5.10
unnamed: J5.12, R20.2
