ksmonkey123/moba3/pcbs/switch_decoder/decoder.kicad_pcb

## KiCad design pcbs/switch_decoder/decoder.kicad_pcb (continued)

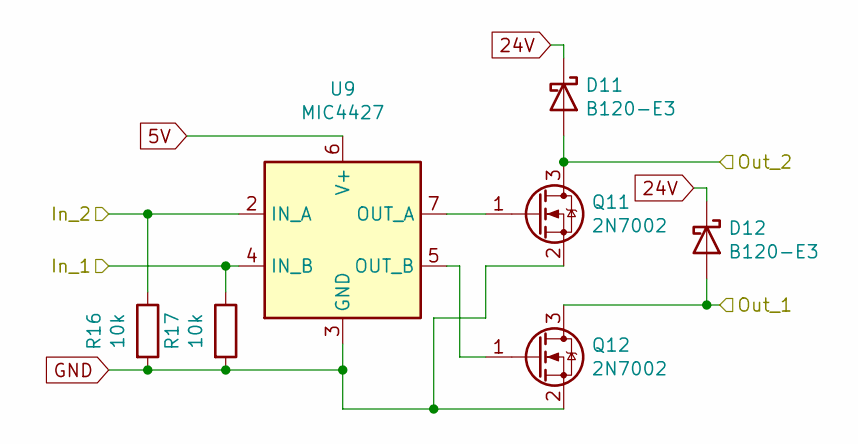
[picture p33: schematic driver.sch]

Parts:
D1, D2: B120-E3; D_SMA
Q1, Q2: 2N7002; SOT-23
R6, R7: 10k; R_0603_1608Metric
U3: MIC4427; SOIC-8_3.9x4.9mm_P1.27mm

Connections:
5V: U3.6 (V+); also elsewhere on the board
24V: D1.1 (K), D2.1 (K); also elsewhere on the board
/switch 1/Out_1: D2.2 (A), Q2.3 (D); also elsewhere on the board
/switch 1/Out_2: D1.2 (A), Q1.3 (D); also elsewhere on the board
GND: Q1.2 (S), Q2.2 (S), R6.2, U3.3 (GND); also elsewhere on the board
unnamed: Q1.1 (G), U3.7 (OUT_A)
unnamed: Q2.1 (G), U3.5 (OUT_B)

Parts of its further copies:
D3, D4, D5, D6, D7, D8, D9, D10, D11, D12: B120-E3; D_SMA
Q3, Q4, Q5, Q6, Q7, Q8, Q9, Q10, Q11, Q12: 2N7002; SOT-23
R4, R5, R9, R10, R11, R12, R13, R14, R15, R16, R17: 10k; R_0603_1608Metric
U5, U6, U7, U8, U9: MIC4427; SOIC-8_3.9x4.9mm_P1.27mm

Connections of its further copies:
5V: U5.6 (V+), U6.6 (V+), U7.6 (V+), U8.6 (V+), U9.6 (V+); also elsewhere on the board
24V: D3.1 (K), D4.1 (K), D5.1 (K), D6.1 (K), D7.1 (K), D8.1 (K), D9.1 (K), D10.1 (K), D11.1 (K), D12.1 (K); also elsewhere on the board
/switch 2/In_1: R9.1, U5.4 (IN_B); also elsewhere on the board
/switch 2/Out_1: D4.2 (A), Q4.3 (D); also elsewhere on the board
/switch 2/Out_2: D3.2 (A), Q3.3 (D); also elsewhere on the board
/switch 3/In_1: R11.1, U6.4 (IN_B); also elsewhere on the board
/switch 3/In_2: R10.1, U6.2 (IN_A); also elsewhere on the board
/switch 3/Out_1: D6.2 (A), Q6.3 (D); also elsewhere on the board
/switch 3/Out_2: D5.2 (A), Q5.3 (D); also elsewhere on the board
/switch 4/In_1: R13.1, U7.4 (IN_B); also elsewhere on the board
/switch 4/Out_1: D8.2 (A), Q8.3 (D); also elsewhere on the board
/switch 4/Out_2: D7.2 (A), Q7.3 (D); also elsewhere on the board
/switch 5/In_1: R15.1, U8.4 (IN_B); also elsewhere on the board
/switch 5/In_2: R14.1, U8.2 (IN_A); also elsewhere on the board
/switch 5/Out_1: D10.2 (A), Q10.3 (D); also elsewhere on the board
/switch 5/Out_2: D9.2 (A), Q9.3 (D); also elsewhere on the board
/switch 6/In_1: R17.1, U9.4 (IN_B); also elsewhere on the board
/switch 6/In_2: R16.1, U9.2 (IN_A); also elsewhere on the board
/switch 6/Out_1: D12.2 (A), Q12.3 (D); also elsewhere on the board
/switch 6/Out_2: D11.2 (A), Q11.3 (D); also elsewhere on the board
GND: Q3.2 (S), Q4.2 (S), Q5.2 (S), Q6.2 (S), Q7.2 (S), Q8.2 (S), Q9.2 (S), Q10.2 (S), Q11.2 (S), Q12.2 (S), R4.2, R5.2, R9.2, R10.2, R11.2, R12.2, R13.2, R14.2, R15.2, R16.2, R17.2, U5.3 (GND), U6.3 (GND), U7.3 (GND), U8.3 (GND), U9.3 (GND); also elsewhere on the board
unnamed: Q3.1 (G), U5.7 (OUT_A)
unnamed: Q4.1 (G), U5.5 (OUT_B)
unnamed: Q5.1 (G), U6.7 (OUT_A)
unnamed: Q6.1 (G), U6.5 (OUT_B)
unnamed: Q7.1 (G), U7.7 (OUT_A)
unnamed: Q8.1 (G), U7.5 (OUT_B)
unnamed: Q9.1 (G), U8.7 (OUT_A)
unnamed: Q10.1 (G), U8.5 (OUT_B)
unnamed: Q11.1 (G), U9.7 (OUT_A)
unnamed: Q12.1 (G), U9.5 (OUT_B)

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
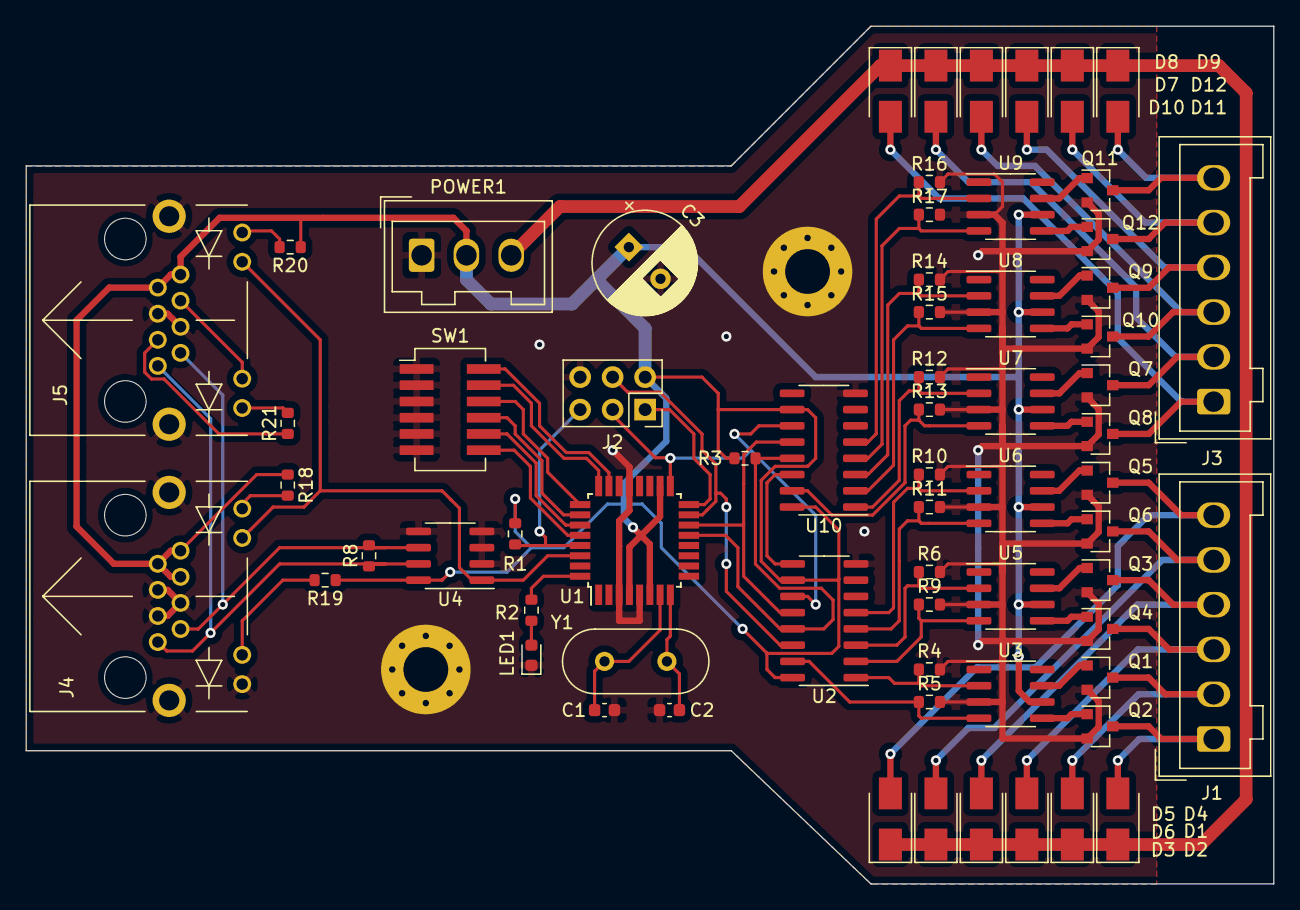
[picture p34: board decoder.kicad_pcb from above]

Board: 2 copper layers, 97.5 x 67.1 mm, 68 parts (1 on the bottom side), 65 nets.
