ksmonkey123/moba3/code/servo_control/settings.h

#include <Arduino.h>

#define PIN_SERVO A3

#define PIN_LED_A 0
#define PIN_LED_B A1
#define PIN_LED_C 10

#define PIN_TOGGLE A4
#define PIN_TRIGGER_A 8
#define PIN_TRIGGER_B 9

#define PIN_CALIBRATION_A A5
#define PIN_CALIBRATION_B A2

#define BOOT_DELAY_MS 500
