ksmonkey123/moba3/code/controller/src/input/buttonMapping.h

#ifndef BUTTON_MAPPINGS_H
#define BUTTON_MAPPINGS_H

#define BUTTON_YARD_01 0x00
#define BUTTON_YARD_02 0x01
#define BUTTON_YARD_03 0x02
#define BUTTON_YARD_04 0x03
#define BUTTON_YARD_05 0x04
#define BUTTON_YARD_06 0x05
#define BUTTON_YARD_07 0x06
#define BUTTON_YARD_08 0x07
#define BUTTON_YARD_09 0x08
#define BUTTON_YARD_10 0x09
#define BUTTON_YARD_L  0x0a
#define BUTTON_YARD_R  0x0b
#define BUTTON_YARD_CL 0x0c

#define BUTTON_TRACK_C 0x18
#define BUTTON_TRACK_1 0x10
#define BUTTON_TRACK_2 0x11
#define BUTTON_TRACK_3 0x12
#define BUTTON_TRACK_4 0x13
#define BUTTON_TRACK_5 0x14
#define BUTTON_TRACK_6 0x15
#define BUTTON_TRACK_7 0x16
#define BUTTON_TRACK_8 0x17

#define BUTTON_STATION_TRACK_1 0x20
#define BUTTON_STATION_TRACK_2 0x21
#define BUTTON_STATION_TRACK_3 0x22
#define BUTTON_STATION_TRACK_4 0x23

#define BUTTON_STATION_ENTRY_L 0x24
#define BUTTON_STATION_SHUNT_1 0x26
#define BUTTON_STATION_SHUNT_2 0x25
#define BUTTON_STATION_CLEAR_L 0x2a

#define BUTTON_STATION_ENTRY_R_1 0x27
#define BUTTON_STATION_ENTRY_R_2 0x28
#define BUTTON_STATION_CLEAR_R_1 0x2b
#define BUTTON_STATION_CLEAR_R_2 0x2c

#define BUTTON_KEYBOARD_01 0x30
#define BUTTON_KEYBOARD_02 0x31
#define BUTTON_KEYBOARD_03 0x32
#define BUTTON_KEYBOARD_04 0x33
#define BUTTON_KEYBOARD_05 0x34
#define BUTTON_KEYBOARD_06 0x35
#define BUTTON_KEYBOARD_07 0x36
#define BUTTON_KEYBOARD_08 0x37
#define BUTTON_KEYBOARD_09 0x38
#define BUTTON_KEYBOARD_10 0x39
#define BUTTON_KEYBOARD_11 0x3a
#define BUTTON_KEYBOARD_12 0x3b
#define BUTTON_KEYBOARD_13 0x3c
#define BUTTON_KEYBOARD_14 0x3d
#define BUTTON_KEYBOARD_15 0x3e

#define BUTTON_DARKMODE 0x3f
#define BUTTON_SWITCHES_DISABLED 0x0d

#endif
