ksmonkey123/moba3/code/controller/src/utils.h

#ifndef UTILS_H
#define UTILS_H

#include <Arduino.h>

namespace Util {
    byte decodeHexNibble(char string);
    /**
     * convert a single byte of data to the 2-character hex representation.
     * 
     * @param data the raw byte to parse
     * @param buffer the output buffer. needs at least 2 bytes of space.
     */
    void byteToHex(byte data, char* buffer);

    union Raw16 {
        uint16_t value;
        uint8_t raw[2];
    };
}

#endif
