ksmonkey123/moba3/(commit log)

2021-05-30 decoder boards and code
    [decoder.kicad_pcb, decoder.sch, driver.sch, networking.sch]
2021-06-01 first switch controller
2021-06-02 I/O LEDS & yard implementation (legacy)
    [shield.kicad_pcb, shield.sch]
2021-06-19 produced PCBs, dropped baudrate, removed on-board dynamic address selection - decoder must now be configured via programmer!
    [Output.sch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]
2021-07-13 revision b of boards
    [decoder.kicad_pcb, decoder.sch, interface.kicad_pcb, interface.sch, networking.sch, shield.kicad_pcb, shield.sch]
2021-07-13 decoder tweaks: status led, no more masking, no external config, slower baudrate
2021-09-06 finished railway control elements
2021-09-07 basic implementation of I/O board
    closes #1
2021-09-07 staggered switch commands
    switch commands are now transmitted over time instead of all at once. this reduces load on power delivery circuitry. closes #2
2021-09-07 redriving command for switch decoders
    allow the controller to order switch decoders to re-drive a switch to a previously transmitted state. This can be used to force the switch back into the correct position after e.g. moving it by hand.
    closes #3
    [switches.cpp]
2021-09-07 force switch re-driving when switch PSU is enabled
    whenever the switch PSU is enabled, force all switch drivers to drive their switches again. closes #4
    also some cleanup of debug logging. previously logging messages took up 30% of used static memory... now only timer creation is logged and log messages use only 18 bytes of memory.
2021-09-08 forced update after switch PSU enabling is delayed by 1 switch staggering period to allow the PSU time to stabilize
    [switches.cpp, switches.h]
2021-10-01 pcb reference pictures
2021-10-01 cropped pcb reference pictures
2021-10-03 button command specification
2021-10-09 fixed #11 - light decoders now use big-endian hex encoding
    [decoder.cpp, light.cpp, utils.cpp, utils.h]
2021-11-05 staggered light updates
    added pulsed button feature for simpler testing
2021-11-25 fixed IOIB not communicating properly with CTRB
    windows linebreaks in Serial.println()....
    [eventHandler.cpp, network.cpp]
2021-11-28 testing fixes:
    CTRB:
    - fixed bad routing in right station entry
    - fixed left station signals not clearing with paths
    - disabled forced switch updates
    IOIB:
    - status led blinking when display data changes
    - status led enabling when no data packed for too long
    DCDR:
    - reduced switch driving times to 500ms
    [controller.cpp, decoder.cpp]
2021-12-09 servo driver
    [networking.sch, servo_driver.kicad_pcb, servo_driver.sch]
2021-12-11 servo driver rev. A
    [servo_driver.kicad_pcb, servo_driver.sch]
2021-12-12 improved servo control (disable position sensing during switching cycle to reduce overshoot)
    [servo_control.cpp, settings.h]
2021-12-20 Rev. A servo board
    [servo_driver.sch]
2021-12-20 servo revisions
2022-11-25 controller shield rev. A and code support
    [controller_uno_shield.kicad_pcb, controller_uno_shield.sch, networking.sch]
2022-11-26 proxy mode for controller
    proxy mode allows a user connected to the controller via USB to open a direct proxy channel to the remote bus: the controller reads incoming data (from USB) and forwards it to the busses. IOIB data is ignored and no refreshing is performed: the controller becomes a dumb proxy until it is reset.
    [controller.cpp, directProxy.cpp, network.cpp, settings.h]
2022-12-14 multi-sample button handling in I/O board
    single-sample processing is vulnerable to sampling errors (interference effects, stray capacitances, etc...).
    as a solution we record 3 samples.
    only after 3 samples have been recorded, we process the data.
    Between the 3 samples majority rule is used for each bit. This allows masking of a single outlier within each sample.
    untested as of yet
    [buttons.cpp]
2022-12-25 IOIB: min delay between samples
